calincalin644/3-in-1arcade/(commit log)

2026-09-26 movement at 30Hz to reduce area
2026-09-26 shorter readme, more area squeeze: removed 7-seg decoder and kept 3-horizontal segment (d,d+g,d+g+a for 1,2,3 lives)
    [render.v, test.py, tt_um_breakout.v, unit.v]
2026-10-02 Add demo-board game selection via gamepad shortcuts in addition to DIP switches (for better gamepad experience)
    [arcade_boot.py, arcade_gamepad.py, run_game.py, test_board_controls.py]
2026-10-03 sharing the power timer, simplifying the win/lose rectangles and lives display, and shortening the gamepad watchdog
    [pellets.v, reference_games.v, tt_um_breakout.v, unit.v]
2026-10-03 replaced ghost hunting with teleportation on power-up
    [compare.v, pellets.v, reference_games.v, test.py, tt_um_breakout.v, unit.v]
2026-10-03 saved 4 ff from removing left/right dip-switch synchronizers
2026-10-03 Fix Pong rally loop, wait for Breakout serve, and speed up video tests
    [arcade_boot.py, reference_games.v, test.py, test_board_controls.py, tt_um_breakout.v, unit.v]
2026-10-03 updated docu to match current modifications
2026-10-03 reverting to square lives instead of horizontal bar
    [test.py, tt_um_breakout.v]
2026-10-03 improvement in motion blur: moving balls hide on alternate frames and remain visible before serving
